IstiaMecatroniqueClub/Motor_Board/documentation/html/class_counter__coll__graph.png

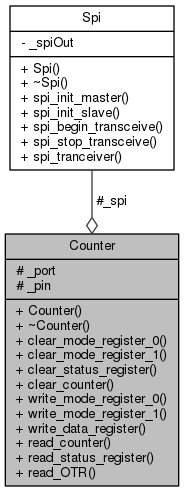
documentation/html/class_counter__coll__graph.png
