IstiaMecatroniqueClub/Motor_Board/documentation/html/class_m32m1__pll__coll__graph.png

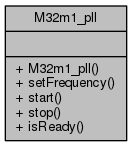
documentation/html/class_m32m1__pll__coll__graph.png
