IstiaMecatroniqueClub/Motor_Board/documentation/html/class_m32m1__pwm__coll__graph.png

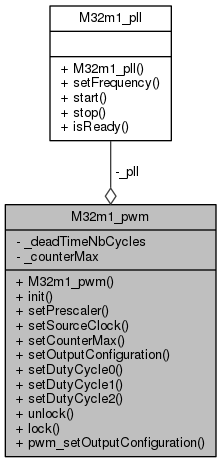
documentation/html/class_m32m1__pwm__coll__graph.png
