IstiaMecatroniqueClub/Motor_Board/documentation/html/class_motor__dc__coll__graph.png

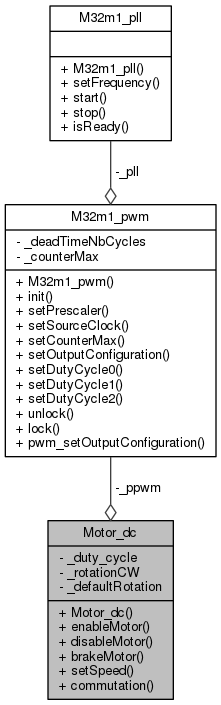
documentation/html/class_motor__dc__coll__graph.png
