IstiaMecatroniqueClub/Motor_Board/documentation/html/class_pid__coll__graph.png

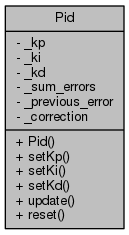
documentation/html/class_pid__coll__graph.png
