IstiaMecatroniqueClub/Motor_Board/documentation/html/class_spi__coll__graph.png

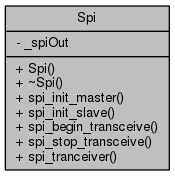
documentation/html/class_spi__coll__graph.png
