IstiaMecatroniqueClub/Motor_Board/documentation/html/counter_8cpp__incl.png

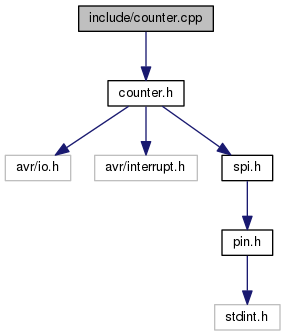
documentation/html/counter_8cpp__incl.png
