IstiaMecatroniqueClub/Motor_Board/documentation/html/counter_8h__incl.png

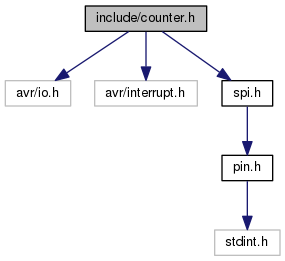
documentation/html/counter_8h__incl.png
