IstiaMecatroniqueClub/Motor_Board/documentation/html/m32m1__pll_8cpp__incl.png

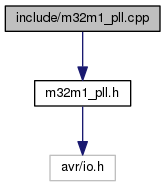
documentation/html/m32m1__pll_8cpp__incl.png
