IstiaMecatroniqueClub/Motor_Board/documentation/html/m32m1__pwm_8h__dep__incl.png

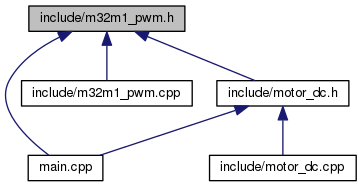
documentation/html/m32m1__pwm_8h__dep__incl.png
