IstiaMecatroniqueClub/Motor_Board/documentation/html/motor__dc_8cpp__incl.png

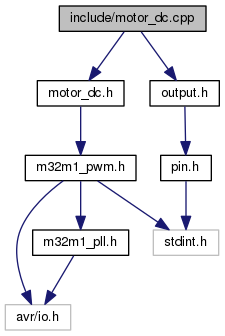
documentation/html/motor__dc_8cpp__incl.png
