IstiaMecatroniqueClub/Motor_Board/documentation/html/motor__dc_8h__incl.png

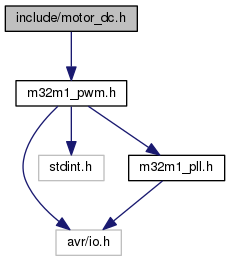
documentation/html/motor__dc_8h__incl.png
