IstiaMecatroniqueClub/Motor_Board/documentation/html/pid_8cpp__incl.png

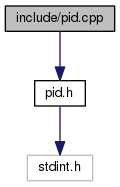
documentation/html/pid_8cpp__incl.png
