IstiaMecatroniqueClub/Motor_Board/documentation/html/spi_8cpp__incl.png

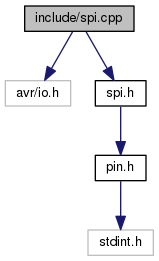
documentation/html/spi_8cpp__incl.png
