IstiaMecatroniqueClub/Motor_Board/documentation/html/spi_8h__dep__incl.png

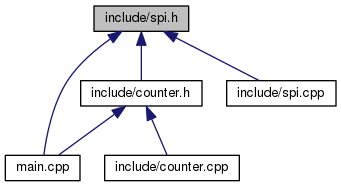
documentation/html/spi_8h__dep__incl.png
