IstiaMecatroniqueClub/Motor_Board/board/solidworks/motorboard.SLDASM

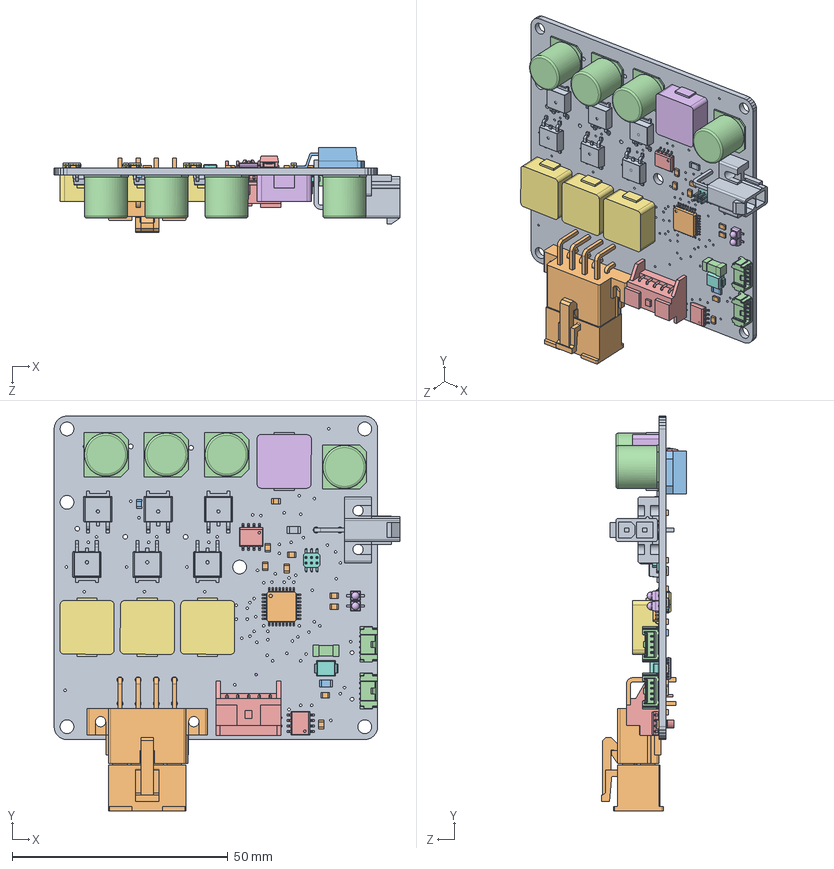
[picture p22: CAD file, 2017-06-15]
board/solidworks/motorboard.SLDASM
80.2 x 91.5 x 19.8 mm
motorboard_v2
C2012 x 20
EIA3216 x 4
153CLV-1010 x 4
EIA7343
VLD x 2
SOD323 x 4
403A-03
R3216
TQFP32
to263-5
S05B-XASK-1
DRA124
DRA127 x 3
crystal_KX7 x 2
TO252 x 6
R2012 x 8
T2012
EIARS-481-2
SOIC8 x 2
TSSOP14
MSOP8 x 3
MINITEK_127_6WAY_SMD_MINITEK_6WAY
