IstiaMecatroniqueClub/Motor_Board/(list of files, cad)

Other CAD files:
board/solidworks/motorboard_v2.SLDASM
