IstiaMecatroniqueClub/Motor_Board/board/schematics/Schématics.pdf

A

A

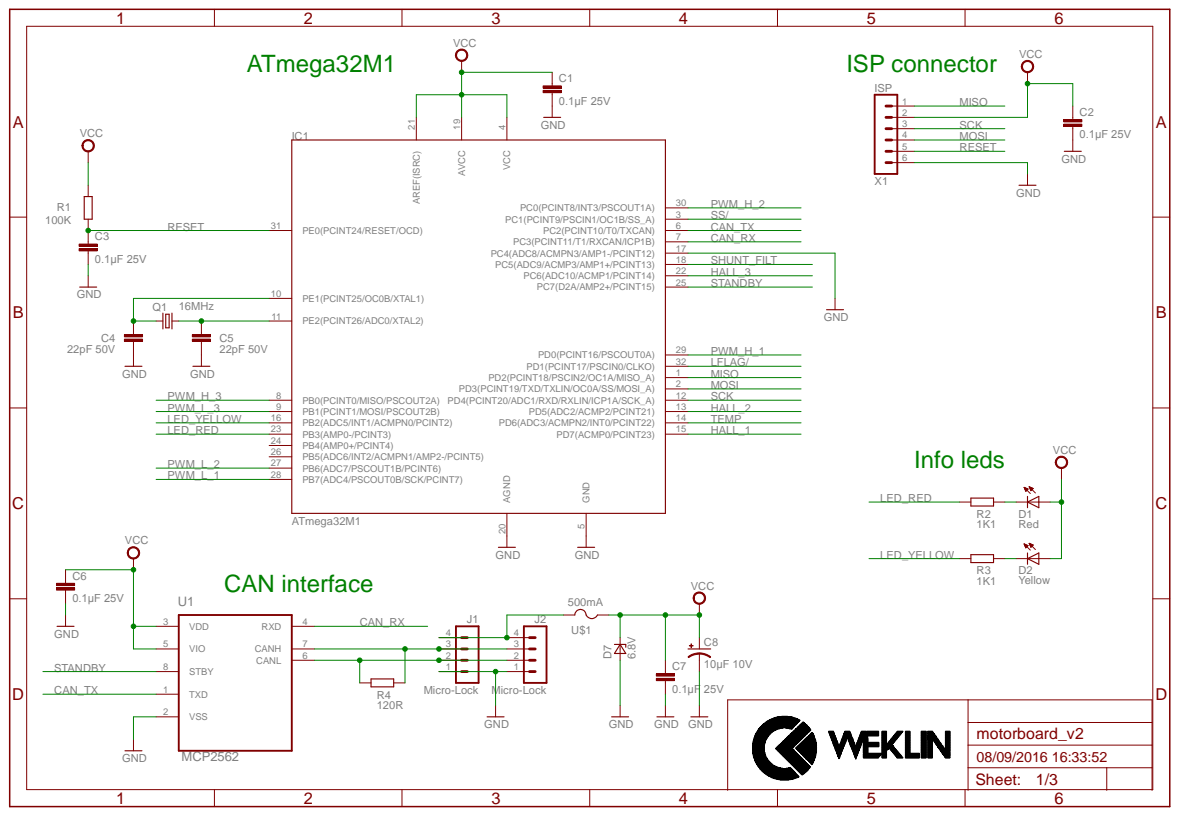
[picture p23: page 1]

A

A

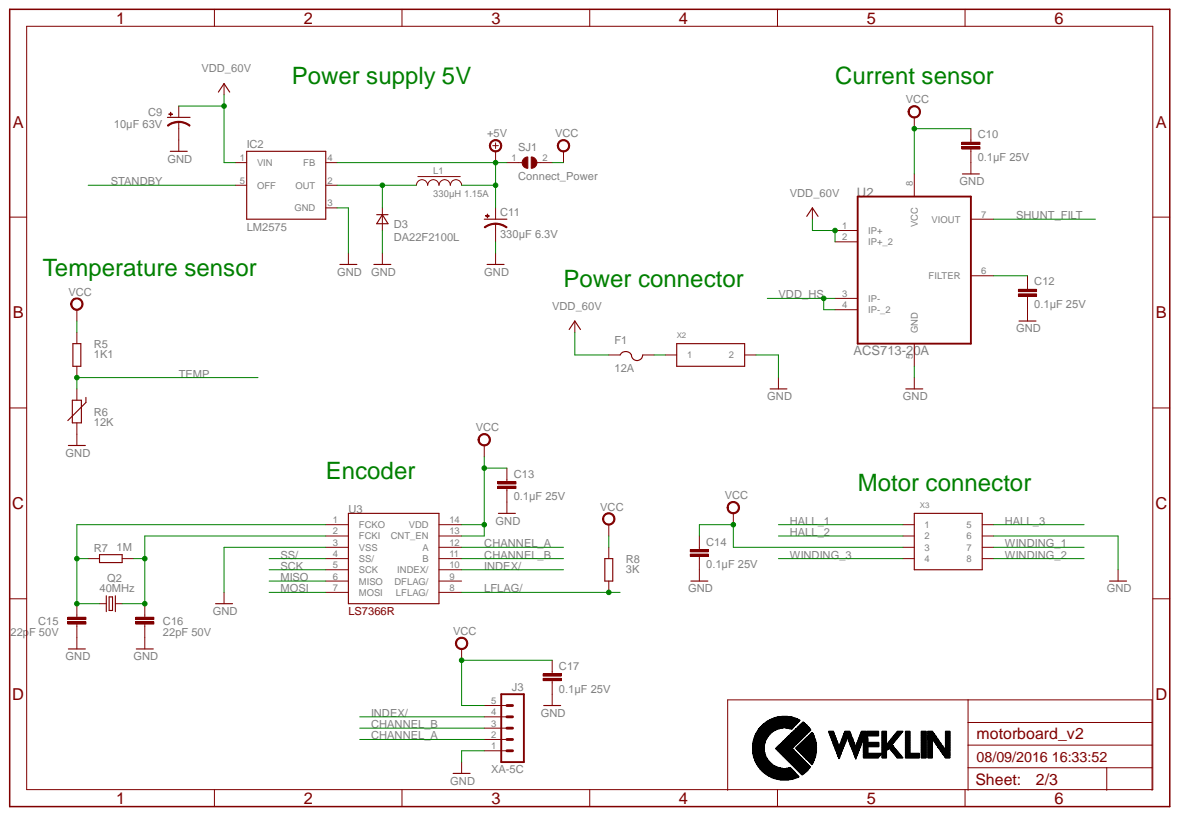
[picture p24: page 2]

VDD_60V

Power connector Temperature sensor

U4

A

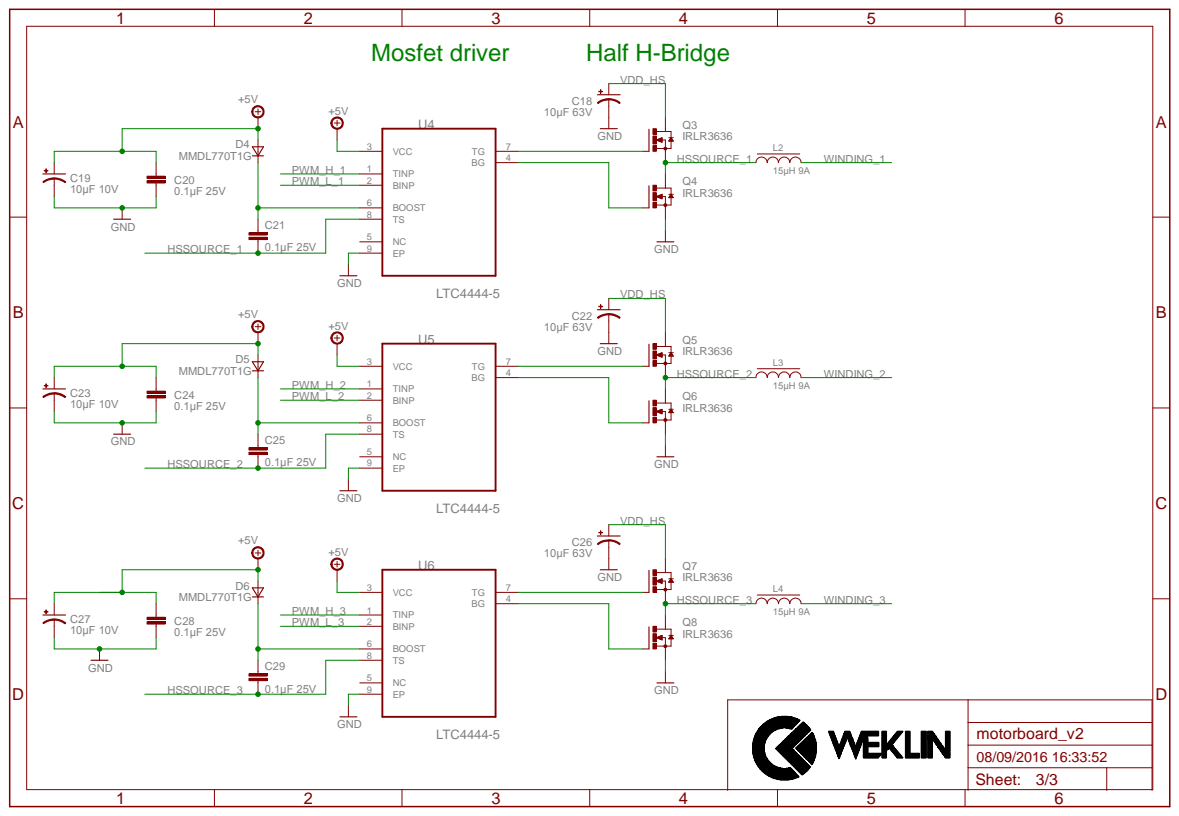
[picture p25: page 3]
