IstiaMecatroniqueClub/Motor_Board/board/schematics/Bottom cooper.pdf

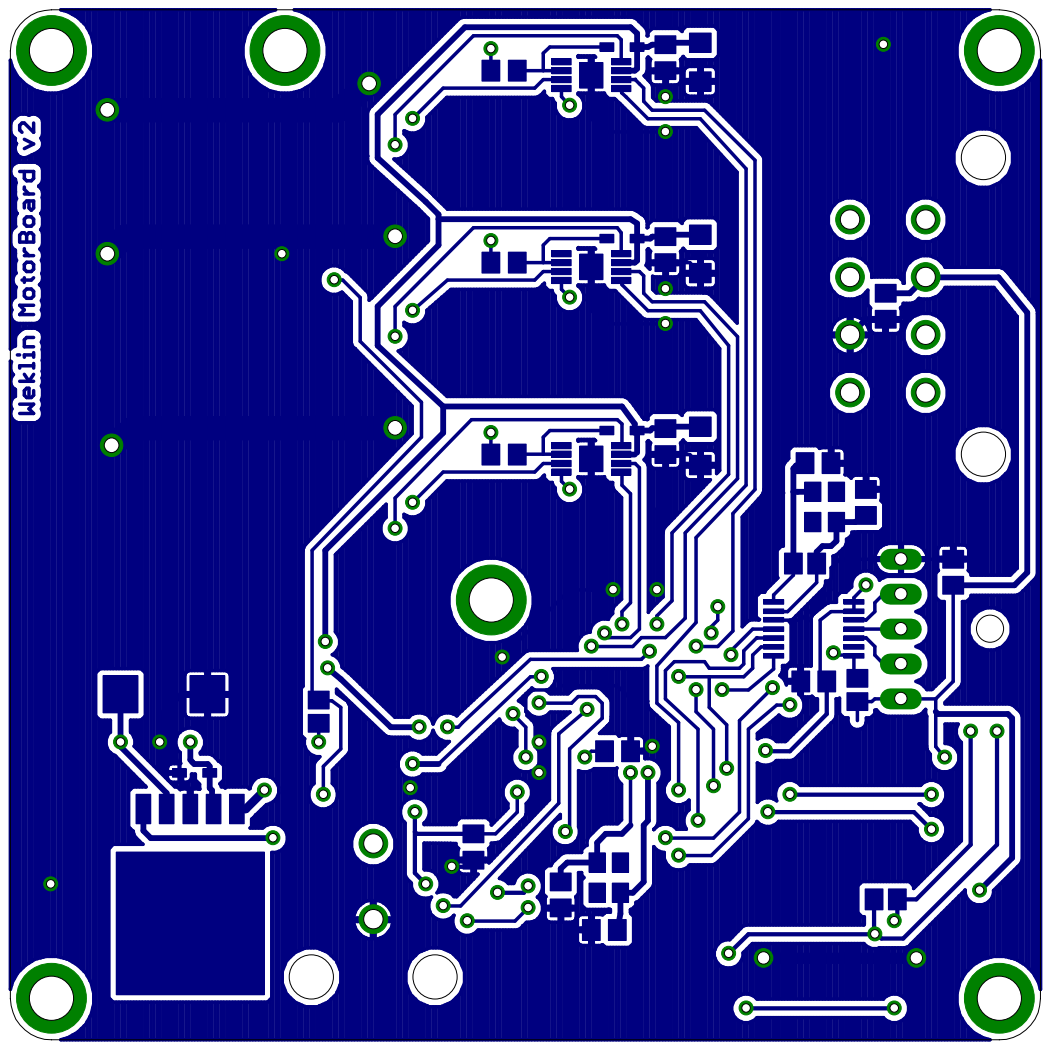
[picture p26: page 1]
