IstiaMecatroniqueClub/Motor_Board/board/schematics/Bottom implantation.pdf

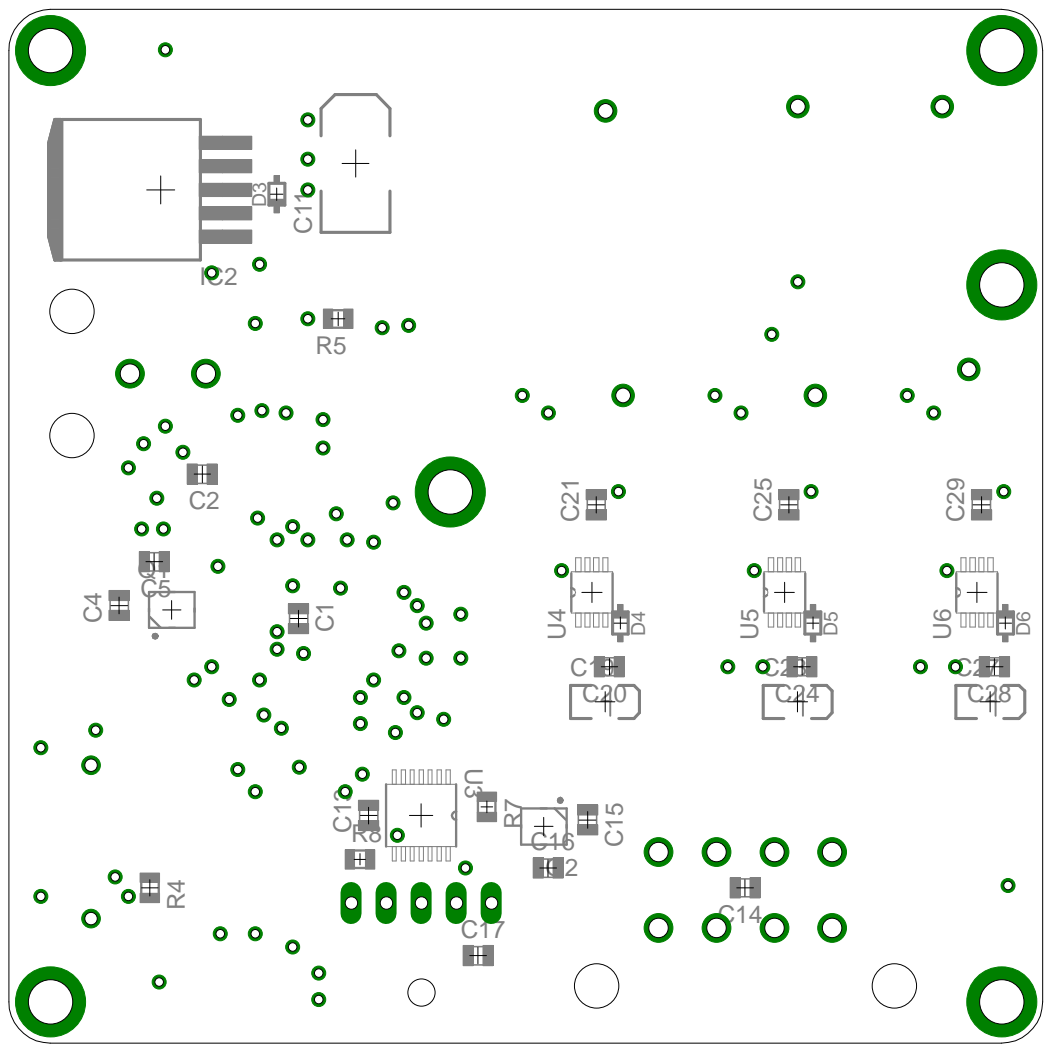
[picture p27: page 1]
