IstiaMecatroniqueClub/Motor_Board/board/schematics/Top cooper.pdf

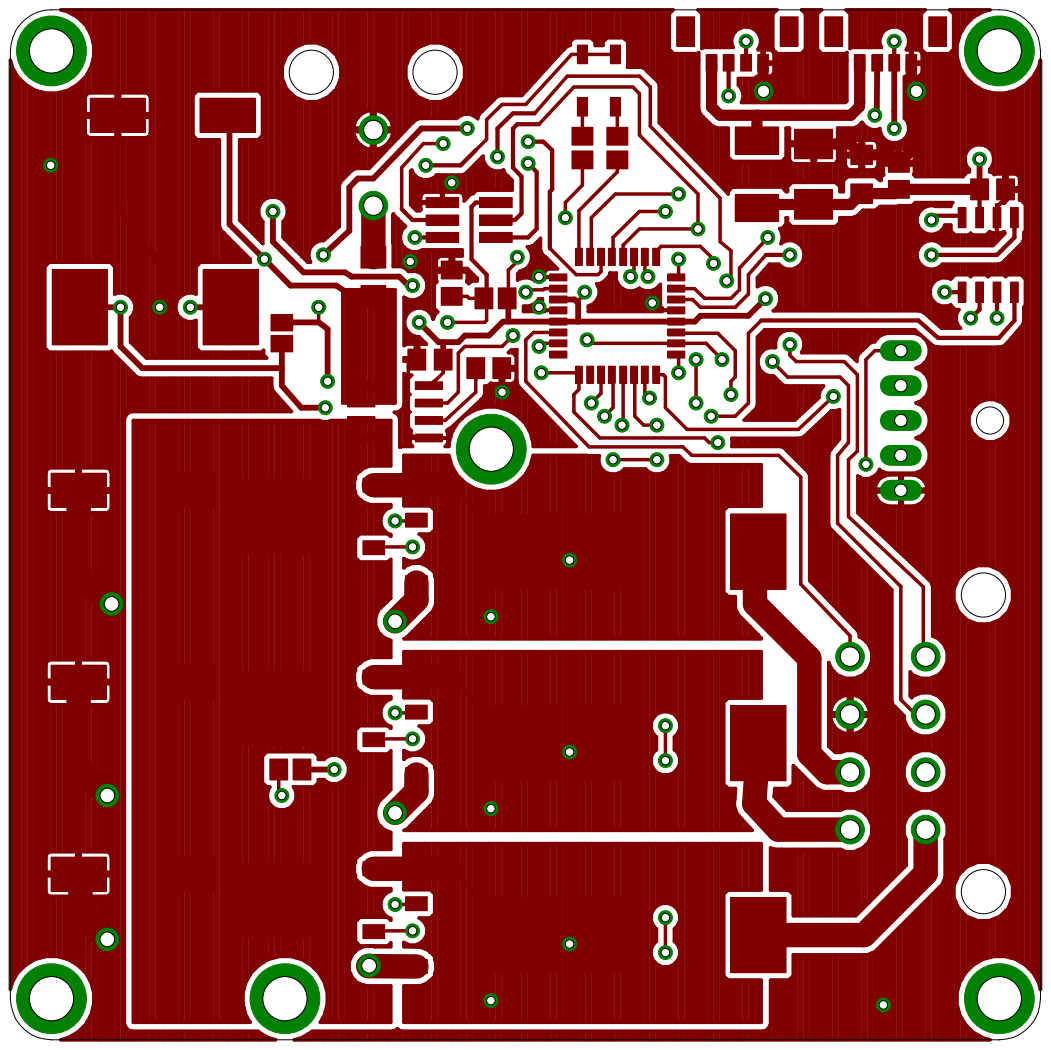
[picture p28: page 1]
