IstiaMecatroniqueClub/Motor_Board/board/schematics/Top implantation.pdf

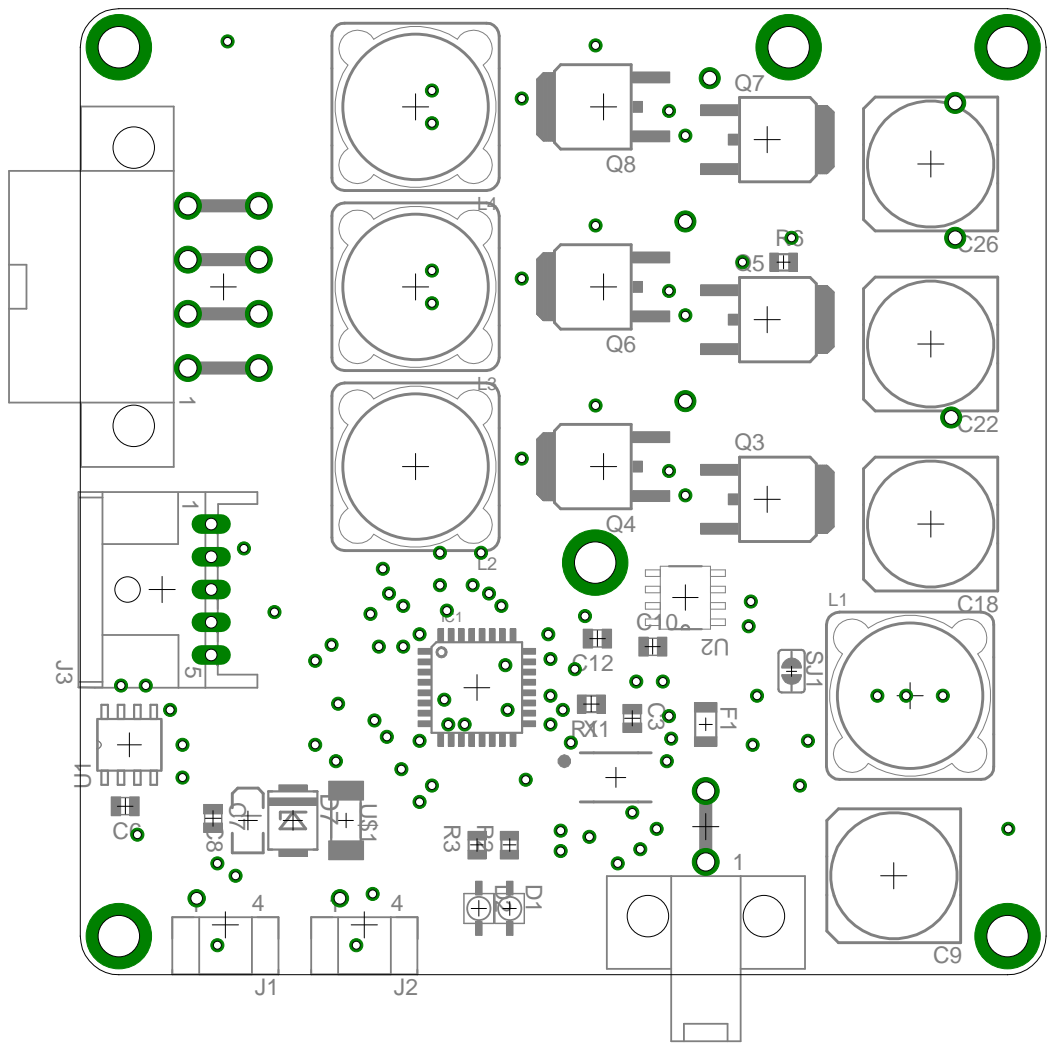
[picture p29: page 1]
