IstiaMecatroniqueClub/Motor_Board/board/schematics/motorboard.brd

## EAGLE design board/schematics/motorboard.brd (2017-06-15)

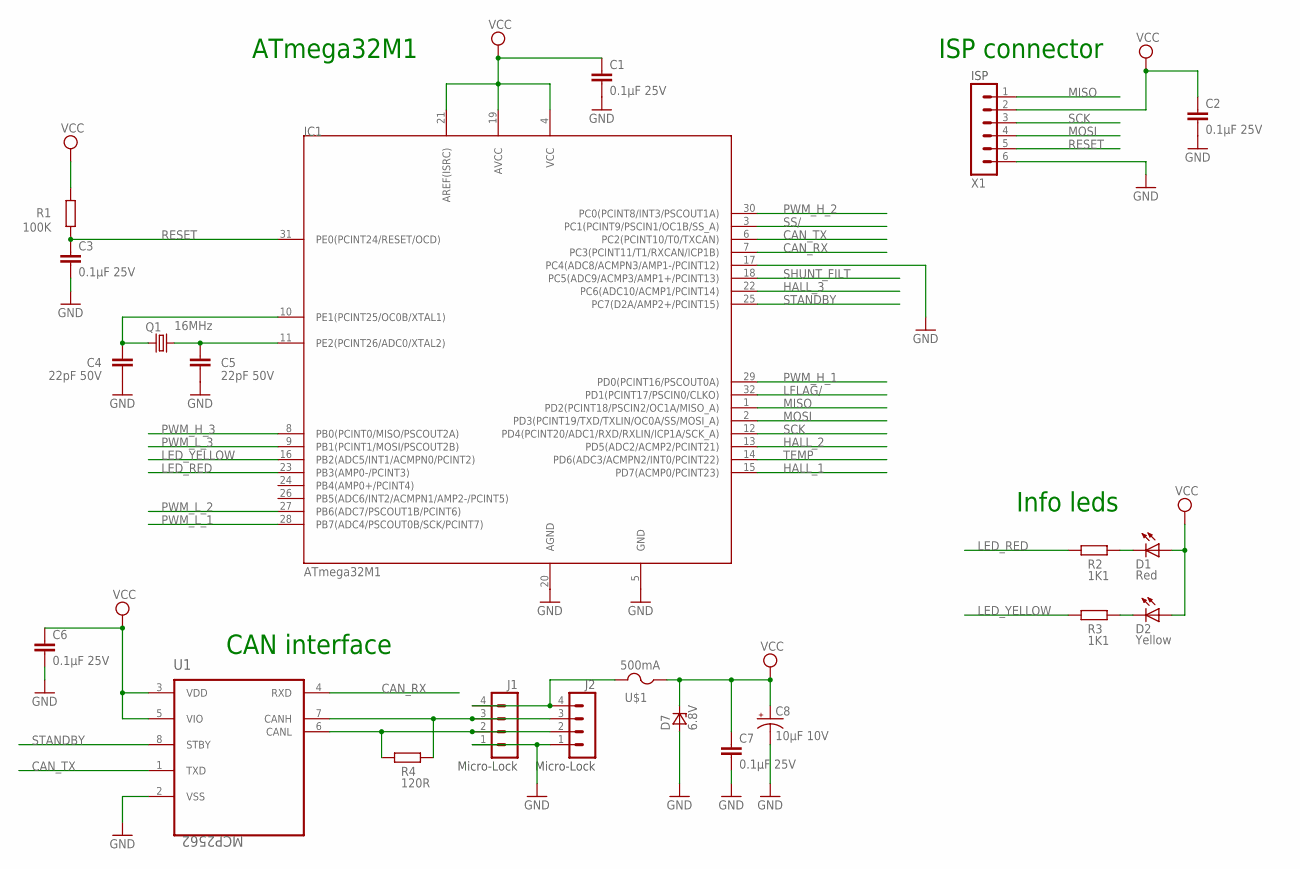
[picture p30: schematic motorboard.sch, sheet 1]

Parts:
C1, C2, C3, C6, C7: 0.1µF 25V; C2012
C4, C5: 22pF 50V; C2012
C8: 10µF 10V; EIA3216
D1: Red; VLD
D2: Yellow; VLD
D7: 6.8V; DO-214AA
IC1: ATmega32M1; TQFP32
J1, J2: Micro-Lock; 504195-0470
Q1: 16MHz; SMD_KX7
R1: 100K; R2012
R2, R3: 1K1; R2012
R4: 120R; R2012
U1: MCP2562; SOIC8
U$1: 500mA; EIARS-481-2
X1: ISP; MINITEK_127_6WAY_SMD

Connections:
CAN_RX: IC1.7 (PC3(PCINT11/T1/RXCAN/ICP1B)), U1.4 (RXD)
CAN_TX: IC1.6 (PC2(PCINT10/T0/TXCAN)), U1.1 (TXD)
GND: C1.2, C2.2, C3.2, C4.2, C5.2, C6.2, C7.2, C8.C (-), D7.A, IC1.5 (GND), IC1.17 (PC4(ADC8/ACMPN3/AMP1-/PCINT12)), IC1.20 (AGND), J1.1, J2.1, U1.2 (VSS), X1.6; also elsewhere on the board
HALL_1: IC1.15 (PD7(ACMP0/PCINT23)); also elsewhere on the board
HALL_2: IC1.13 (PD5(ADC2/ACMP2/PCINT21)); also elsewhere on the board
HALL_3: IC1.22 (PC6(ADC10/ACMP1/PCINT14)); also elsewhere on the board
LED_RED: IC1.23 (PB3(AMP0-/PCINT3)), R2.2
LED_YELLOW: IC1.16 (PB2(ADC5/INT1/ACMPN0/PCINT2)), R3.2
LFLAG/: IC1.32 (PD1(PCINT17/PSCIN0/CLKO)); also elsewhere on the board
MISO: IC1.1 (PD2(PCINT18/PSCIN2/OC1A/MISO_A)), X1.1; also elsewhere on the board
MOSI: IC1.2 (PD3(PCINT19/TXD/TXLIN/OC0A/SS/MOSI_A)), X1.4; also elsewhere on the board
unnamed: D1.C, R2.1
unnamed: D2.C, R3.1
unnamed: J1.4, J2.4, U$1.2
unnamed: J1.2, J2.2, R4.2, U1.6 (CANL)
unnamed: J1.3, J2.3, R4.1, U1.7 (CANH)
unnamed: C5.1, IC1.11 (PE2(PCINT26/ADC0/XTAL2)), Q1.3 (2)
unnamed: C4.1, IC1.10 (PE1(PCINT25/OC0B/XTAL1)), Q1.1
PWM_H_1: IC1.29 (PD0(PCINT16/PSCOUT0A)); also elsewhere on the board
PWM_H_2: IC1.30 (PC0(PCINT8/INT3/PSCOUT1A)); also elsewhere on the board
PWM_H_3: IC1.8 (PB0(PCINT0/MISO/PSCOUT2A)); also elsewhere on the board
PWM_L_1: IC1.28 (PB7(ADC4/PSCOUT0B/SCK/PCINT7)); also elsewhere on the board
PWM_L_2: IC1.27 (PB6(ADC7/PSCOUT1B/PCINT6)); also elsewhere on the board
PWM_L_3: IC1.9 (PB1(PCINT1/MOSI/PSCOUT2B)); also elsewhere on the board
RESET: C3.1, IC1.31 (PE0(PCINT24/RESET/OCD)), R1.1, X1.5
SCK: IC1.12 (PD4(PCINT20/ADC1/RXD/RXLIN/ICP1A/SCK_A)), X1.3; also elsewhere on the board
SHUNT_FILT: IC1.18 (PC5(ADC9/ACMP3/AMP1+/PCINT13)); also elsewhere on the board
SS/: IC1.3 (PC1(PCINT9/PSCIN1/OC1B/SS_A)); also elsewhere on the board
STANDBY: IC1.25 (PC7(D2A/AMP2+/PCINT15)), U1.8 (STBY); also elsewhere on the board
TEMP: IC1.14 (PD6(ADC3/ACMPN2/INT0/PCINT22)); also elsewhere on the board
VCC: C1.1, C2.1, C6.1, C7.1, C8.A (+), D1.A, D2.A, D7.C, IC1.4 (VCC), IC1.19 (AVCC), IC1.21 (AREF(ISRC)), R1.2, U1.3 (VDD), U1.5 (VIO), U$1.1, X1.2; also elsewhere on the board

Notes on the sheet:
ISP connector
Info leds
CAN interface
ATmega32M1

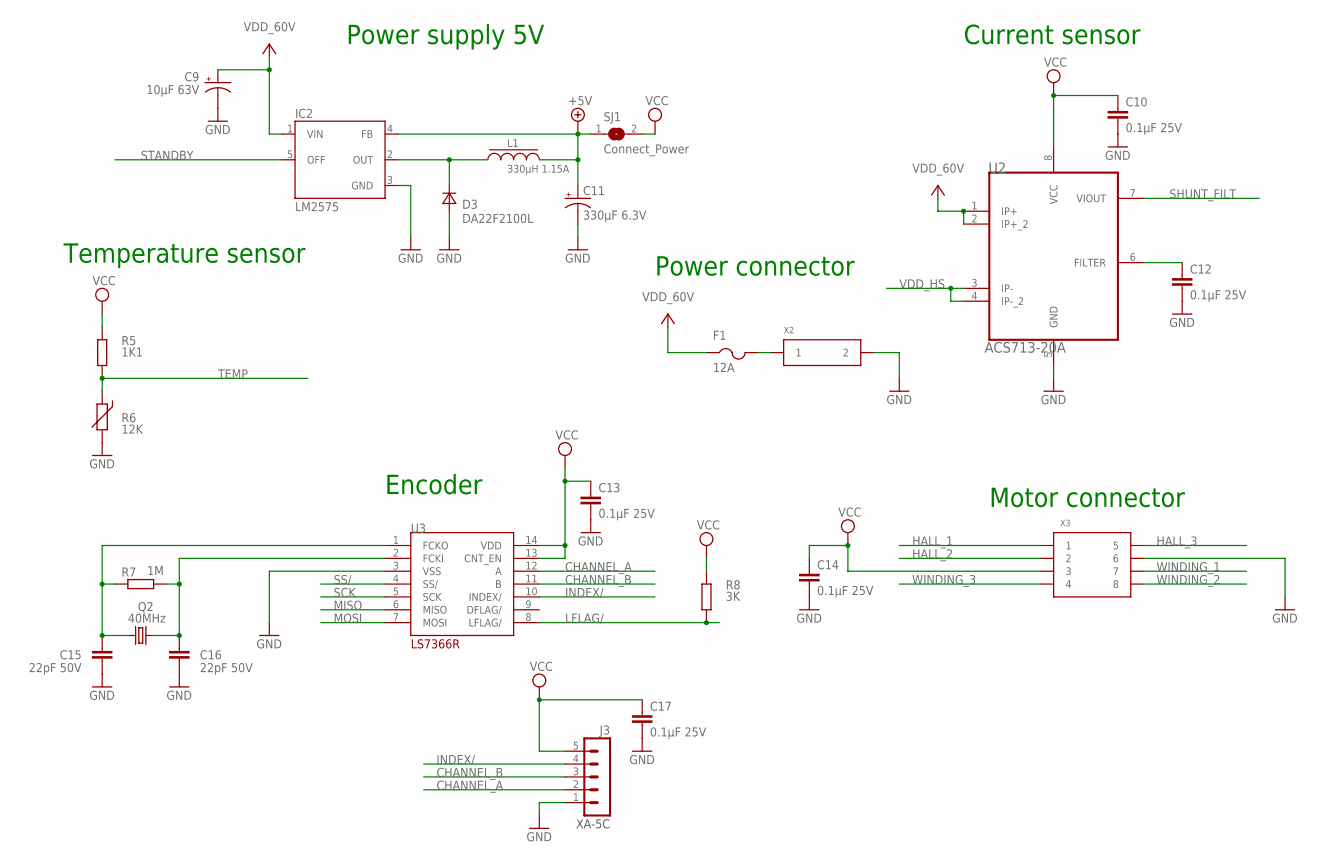
[picture p31: schematic motorboard.sch, sheet 2]

Parts:
C9: 10µF 63V; 153CLV-1010
C10, C12, C13, C14, C17: 0.1µF 25V; C2012
C11: 330µF 6.3V; EIA7343
C15, C16: 22pF 50V; C2012
D3: DA22F2100L; SOD323
F1: 12A; R3216
IC2: LM2575; TO263-5
J3: XA-5C; S05B-XASK-1
L1: 330µH 1.15A; DRA124
Q2: 40MHz; SMD_KX7
R5: 1K1; R2012
R6: 12K; T2012
R7: 1M; R2012
R8: 3K; R2012
SJ1: Connect_Power; SJ
U2: ACS713-20A; SOIC8
U3: LS7366R; TSSOP14
X2: Mini-Fit; 5569-02
X3: Mini-Fit; 5569-08

Connections:
+5V: C11.A (+), IC2.4 (FB), L1.2, SJ1.1; also elsewhere on the board
CHANNEL_A: J3.2, U3.12 (A)
CHANNEL_B: J3.3, U3.11 (B)
GND: C9.-, C10.2, C11.C (-), C12.2, C13.2, C14.2, C15.2, C16.2, C17.2, D3.2 (A), IC2.3 (GND), J3.1, R6.2, U2.5 (GND), U3.3 (VSS), X2.P2 (2), X3.P6 (6); also elsewhere on the board
HALL_1: X3.P1 (1); also elsewhere on the board
HALL_2: X3.P2 (2); also elsewhere on the board
HALL_3: X3.P5 (5); also elsewhere on the board
INDEX/: J3.4, U3.10 (INDEX/)
LFLAG/: R8.2, U3.8 (LFLAG/); also elsewhere on the board
MISO: U3.6 (MISO); also elsewhere on the board
MOSI: U3.7 (MOSI); also elsewhere on the board
unnamed: D3.1 (C), IC2.2 (OUT), L1.1
unnamed: C16.1, Q2.3 (2), R7.2, U3.2 (FCKI)
unnamed: C15.1, Q2.1, R7.1, U3.1 (FCKO)
unnamed: F1.2, X2.P1 (1)
unnamed: C12.1, U2.6 (FILTER)
SCK: U3.5 (SCK); also elsewhere on the board
SHUNT_FILT: U2.7 (VIOUT); also elsewhere on the board
SS/: U3.4 (SS/); also elsewhere on the board
STANDBY: IC2.5 (OFF); also elsewhere on the board
TEMP: R5.1, R6.1; also elsewhere on the board
VCC: C10.1, C13.1, C14.1, C17.1, J3.5, R5.2, R8.1, SJ1.2, U2.8 (VCC), U3.13 (CNT_EN), U3.14 (VDD), X3.P3 (3); also elsewhere on the board
VDD: C9.+, F1.1, IC2.1 (VIN), U2.1 (IP+), U2.2 (IP+_2)
VDD_HS: U2.3 (IP-), U2.4 (IP-_2); also elsewhere on the board
WINDING_1: X3.P7 (7); also elsewhere on the board
WINDING_2: X3.P8 (8); also elsewhere on the board
WINDING_3: X3.P4 (4); also elsewhere on the board

Notes on the sheet:
Current sensor
Power supply 5V
Motor connector
Encoder
Power connector
Temperature sensor

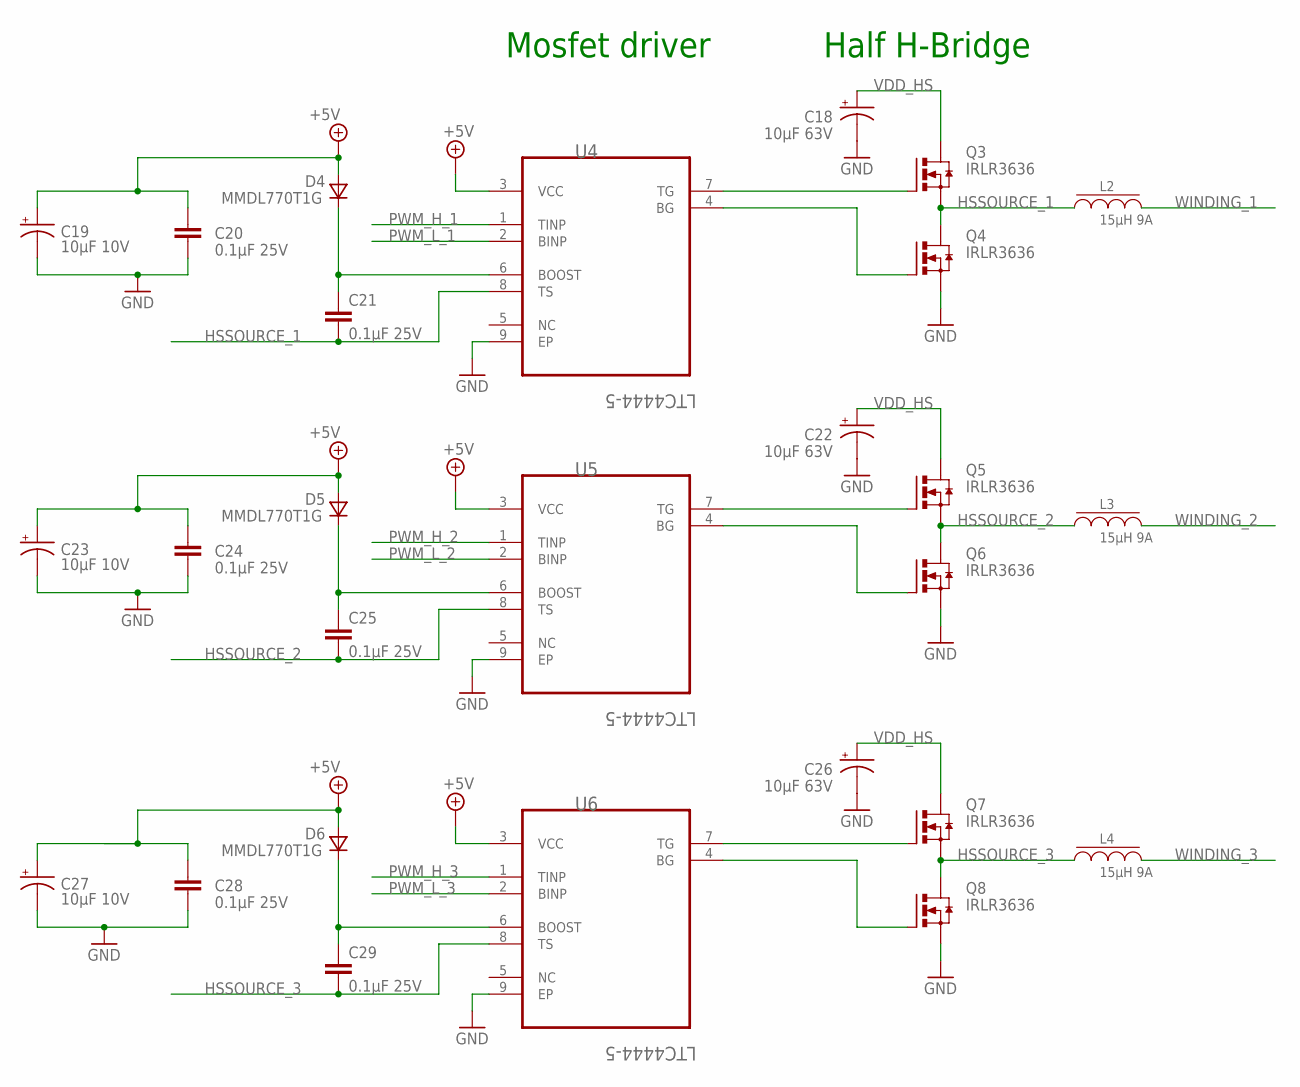
[picture p32: schematic motorboard.sch, sheet 3]

Parts:
C18, C22, C26: 10µF 63V; 153CLV-1010
C19, C23, C27: 10µF 10V; EIA3216
C20, C21, C24, C25, C28, C29: 0.1µF 25V; C2012
D4, D5, D6: MMDL770T1G; SOD323
L2, L3, L4: 15µH 9A; DRA127
Q3, Q4, Q5, Q6, Q7, Q8: IRLR3636; TO252
U4, U5, U6: LTC4444-5; MSOP8

Connections:
+5V: C19.A (+), C20.1, C23.A (+), C24.1, C27.A (+), C28.1, D4.2 (A), D5.2 (A), D6.2 (A), U4.3 (VCC), U5.3 (VCC), U6.3 (VCC); also elsewhere on the board
GND: C18.-, C19.C (-), C20.2, C22.-, C23.C (-), C24.2, C26.-, C27.C (-), C28.2, Q4.3 (S), Q6.3 (S), Q8.3 (S), U4.9 (EP), U5.9 (EP), U6.9 (EP); also elsewhere on the board
HSSOURCE_1: C21.2, L2.1, Q3.3 (S), Q4.4 (D), U4.8 (TS)
HSSOURCE_2: C25.2, L3.1, Q5.3 (S), Q6.4 (D), U5.8 (TS)
HSSOURCE_3: C29.2, L4.1, Q7.3 (S), Q8.4 (D), U6.8 (TS)
unnamed: C25.1, D5.1 (C), U5.6 (BOOST)
unnamed: C21.1, D4.1 (C), U4.6 (BOOST)
unnamed: Q4.1 (G), U4.4 (BG)
unnamed: Q3.1 (G), U4.7 (TG)
unnamed: Q6.1 (G), U5.4 (BG)
unnamed: Q5.1 (G), U5.7 (TG)
unnamed: C29.1, D6.1 (C), U6.6 (BOOST)
unnamed: Q8.1 (G), U6.4 (BG)
unnamed: Q7.1 (G), U6.7 (TG)
PWM_H_1: U4.1 (TINP); also elsewhere on the board
PWM_H_2: U5.1 (TINP); also elsewhere on the board
PWM_H_3: U6.1 (TINP); also elsewhere on the board
PWM_L_1: U4.2 (BINP); also elsewhere on the board
PWM_L_2: U5.2 (BINP); also elsewhere on the board
PWM_L_3: U6.2 (BINP); also elsewhere on the board
VDD_HS: C18.+, C22.+, C26.+, Q3.4 (D), Q5.4 (D), Q7.4 (D); also elsewhere on the board
WINDING_1: L2.2; also elsewhere on the board
WINDING_2: L3.2; also elsewhere on the board
WINDING_3: L4.2; also elsewhere on the board

Notes on the sheet:
Mosfet driver
Half H-Bridge

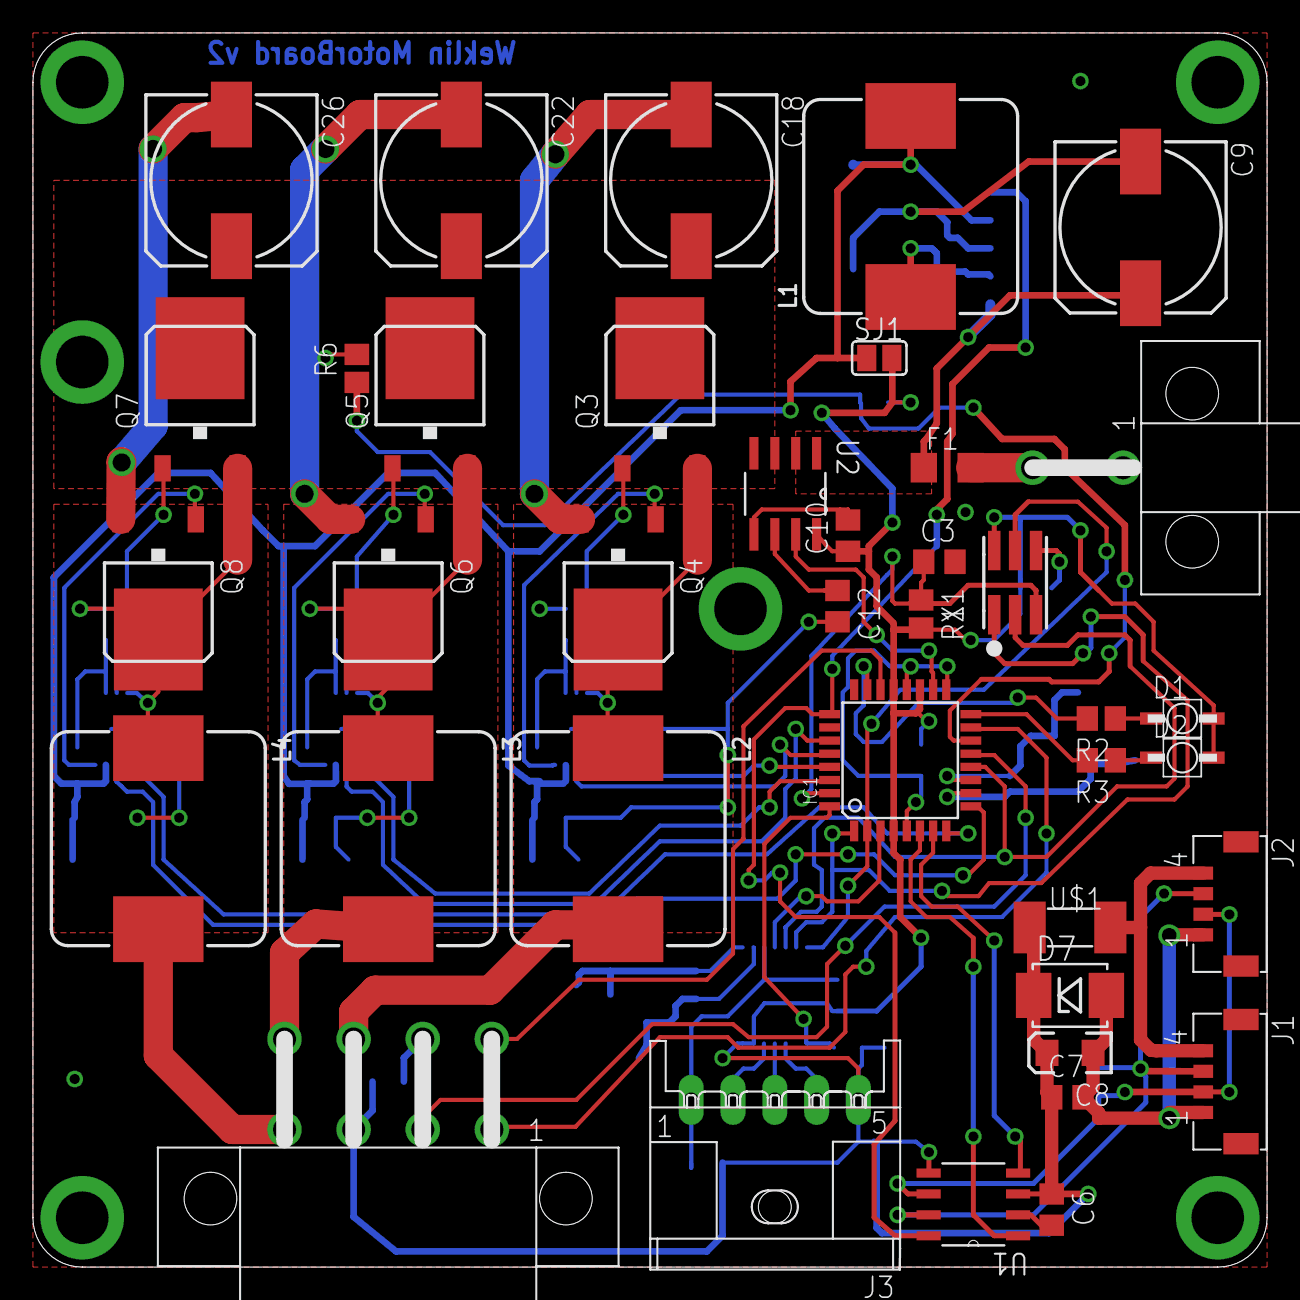
[picture p33: board motorboard.brd from above]

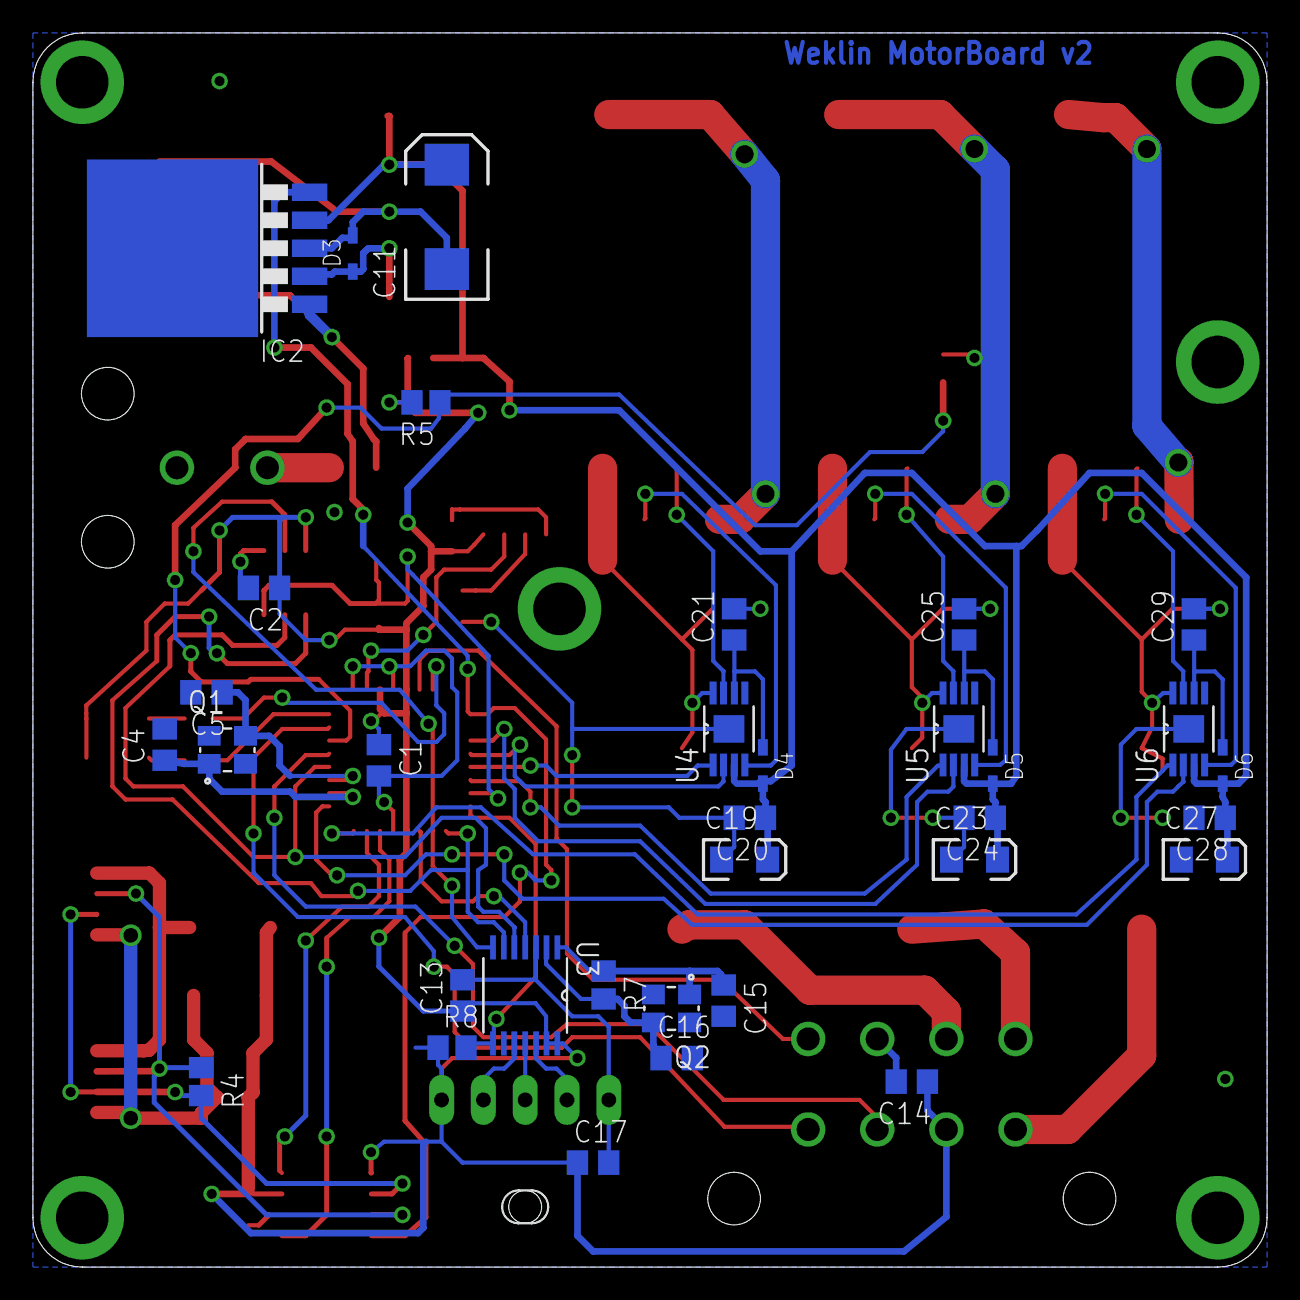
[picture p34: board motorboard.brd from below]

Board: 4 copper layers, 75.0 x 75.0 mm, 73 parts (34 on the bottom side), 57 nets.
