IstiaMecatroniqueClub/Motor_Board/code/include/m32m1_pll.cpp

#include "m32m1_pll.h"

// Constructor, do nothing
M32m1_pll::M32m1_pll()
{}

// Start the PLL (needs about 100ms to start, check pll_isReady)
void M32m1_pll::start()
{
    // Enable PLL
    PLLCSR |= (1<<PLLE);
}



// Set PLL output frequency (64MHz or 32MHz)
void M32m1_pll::setFrequency(bool PLL_Factor)
{
    if (PLL_Factor)
        // Set the bit PLLF of PLLCSR
        PLLCSR |= (1<<PLLF);
    else
        // Clear the bit PLLF of PLLCSR
        PLLCSR &= ~(1<<PLLF);
}

// Stop the PLL
void M32m1_pll::stop()
{
    // Unset bit PLLE of PLLCSR
    PLLCSR &= ~(1<<PLLE);
}

// Return true when the PLL is locked
bool M32m1_pll::isReady()
{
    // Check bit PLOCK of PLLCSR
    return (PLLCSR & (1<<PLOCK) );
}
