IstiaMecatroniqueClub/Motor_Board/(commit log)

2017-06-15 Adding source code and schematics
    [doxygen_configuration.txt, motorboard.SLDASM, motorboard.brd, motorboard.sch, motorboard_v2.SLDASM]
2017-09-18 Ajout lib CanISR, simplification du code, fonctionnement PID on par defaut
2017-09-18 Activation du pid par defaut
